andrew-abdelmalak/connect-4-robot/docs/Vision-Based-Connect-4-Robot-Supplement.pdf

# Vision-Based Connect-4 Robot: Supplementary Material

Andrew Abdelmalak, Daniel Boules, David Girgis, Kirolous Kirolous, Samir Yacoub, and Youssef Salama
Dept. of Mechatronics Engineering, German University in Cairo Cairo, Egypt

Abstract—This document accompanies our paper, Vision-Based Connect-4 Robot: Closed-Loop Game-State Extraction and Verified Token Placement. It collects the material the paper leaves out: how the design developed from a literature review to the final build, the parts and costs of the earlier and final designs, the dispenser’s actuation sequence, per-operation timing on the Raspberry Pi, and detailed drop, timing, and scenario results. All numbers come from the reports we wrote during the project. Where the final code uses different values, the text gives the code’s values.

I. HOW THE DESIGN DEVELOPED
A. Literature Review
We began by surveying three research threads that a visionguided Connect-4 robot depends on: board detection and game-state extraction [1], [2], token colour segmentation under changing light [3], [4], and manipulators for board games [5]. The paper’s related-work section discusses these works. The review fixed one design constraint early. Connect-4 tokens fall under gravity once released above a column, so the robot needs no grasping motion, only repeatable placement along one horizontal axis with an error below half the column pitch, about 20 mm on a standard board.
B. Image Pipeline and First Hardware
Next, we built and tested each image operation on a sample board photo: rotation and perspective warp, each with nearestneighbour and bilinear interpolation; a brightness shift and contrast scaling, each checked with histograms; and Gaussian smoothing at 3×3, 5×5, and 7×7 against a box filter. Bilinear interpolation removed the jagged cell boundaries that nearestneighbour sampling produced. The repository’s image-pipeline notebook reproduces these comparisons.
Two image features were defined to drive the actuator: the mean board brightness and the board’s rotation angle. On our test image the mean brightness was 91.19, which mapped to a motor speed of about 35% PWM duty. An Arduino prototype turned a servo from these two values; it is in the repository as
arduino/servo_prototype.
The first mechanism, modelled in SolidWorks, held a stack of tokens over a slide. A DC motor with an end effector pushed out the bottom token, and a servo-driven gate covered the columns that the token should pass, so that it slid into the target column. The planned electronics drove NEMA 17 stepper motors through L298N drivers. Table I lists the cost of this design.

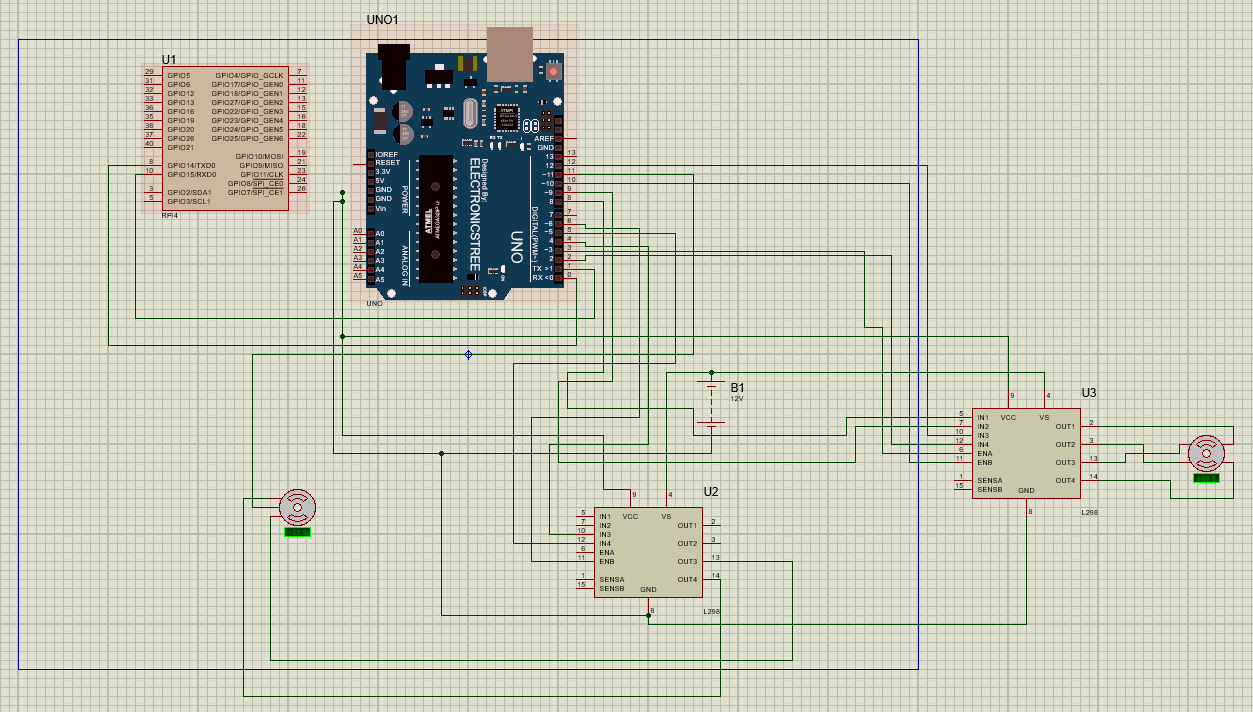
[picture p2: figure]

Fig. 1. Circuit simulated in Proteus for the closed-loop stage: the Arduino Uno, two L298N H-bridge modules for the motors, a 12 V supply, and the servo for the column gate.

C. Closed-Loop Integration

We then connected the stages into one loop: the Raspberry Pi reads the board, plans a move, and sends the column to the Arduino over USB serial, and a Flask dashboard shows the live camera streams. This version still used the stepper motors and the servo gate. Fig. 1 shows the circuit we simulated in Proteus for it.

D. Final Build

Closed-loop testing showed that a simpler split was more repeatable: a time-based carriage driven by a TT geared DC motor, and an encoder-coupled DC motor that releases exactly one token per turn of its disk. The carriage is a rod inside an open rail along the top of the board. At rest it waits out of the board, past the storage end, so every hole is open for the player. Column 1 sits under the chute and needs no move; for column N the rod slides out over columns 1 to N − 1, so the released token rolls along it by gravity and drops through column N, the first open hole. The rod then returns out of the board. The servo and the steppers were removed. The final build cost 6,100 EGP (Table I).

II. ACTUATION SEQUENCE

The Pi sends one ASCII digit, ‘1’ to ‘7’, at 9600 baud. Fig. 2 shows how the sketch that ran in the demonstrations handles each move. The repository’s

TABLE I
PARTS AND COST OF THE EARLIER AND FINAL DESIGNS (EGP)
Component | Qty | Total

Earlier design: steppers and a servo gate
Raspberry Pi 4 (4 GB) | 1 | 5,950
Arduino Uno | 1 | 450
Pi Camera V2 | 1 | 2,150
NEMA 17 stepper motor | 2 | 880
L298N driver | 2 | 170
SG90 micro servo | 1 | 85
12 V 5 A power supply | 1 | 300
Wires and breadboard | 1 | 150
Total | | 10,135

Final build: carriage and magazine
Raspberry Pi 4 (4 GB) | 1 | 4,250
Arduino Uno | 1 | 450
Pi Camera 5MP Rev 1.3 | 1 | 275
TT geared DC motor (carriage) | 1 | 50
Encoder DC motor (magazine) | 1 | 420
L298N H-bridge driver | 1 | 75
12 V 1.2 A power supply | 1 | 50
Wires, breadboard, structural parts | – | 530
Total | | 6,100

on serial input c in ’1’..’7’ and not busy: column <- c - ’0’; busy <- true
emit "BUSY column"
// 1. move the carriage to the column drive carriage out for duration[column] ms hard-brake carriage; wait 2000 ms
// 2. release exactly one token
pulses <- 0; drive magazine motor at fastSpeed while pulses < 430:
if pulses >= 430 - 40: magazine at slowSpeed hard-brake magazine; emit "MAG_PULSES pulses" wait 500 ms
// 3. return the carriage home
drive carriage back for the same time; hard-brake busy <- false; emit "DONE column"

Fig. 2. The dispenser’s per-move sequence, as pseudocode of the sketch that ran in the demonstrations.

arduino/dispenser/dispenser.ino is rebuilt from
this sequence, because the original file was not kept.
The magazine motor turns its disk about 1.075 times per release (430 encoder pulses at 400 counts per turn), which pushes the bottom token out of the storage tube. Hard braking drives both H-bridge inputs high for 100 ms before disabling the channel; it removed coasting and was a key source of repeatable positioning. Table II lists the calibrated carriage times.

III. TIMING ON THE RASPBERRY PI

Each pipeline operation was timed over 100 iterations on the Pi and on a laptop for reference (Table III). Both produce bitfor-bit identical images; the Pi is limited in throughput only. The brightness and contrast settings in the table are the ones used for this benchmark; the robot’s code applies a brightness shift of +20 and a contrast gain of 1.3. Minimax at depth 5

TABLE II
CALIBRATED CARRIAGE DRIVE TIME PER COLUMN
Column | Drive (ms) | Round trip (ms)
1 | 0 | 0
2 | 330 | 660
3 | 600 | 1,200
4 | 900 | 1,800
5 | 1,200 | 2,400
6 | 1,500 | 3,000
7 | 1,800 | 3,600

TABLE III
PER-OPERATION EXECUTION TIME, MEAN OF 100 ITERATIONS (MS)
Operation | Pi 4 | Laptop
Rotation (bilinear) | 8.468 | 3.273
Perspective warp | 3.596 | 1.768
Brightness +60 | 0.734 | 0.888
Contrast α = 1.8 | 1.111 | 0.201
Gaussian blur 5 × 5 | 0.757 | 0.097

typically took 0.2 to 1.4 s on the Pi in the early game, where the branching factor is highest, and less than 0.5 s in later positions.

IV. DETAILED RESULTS

A. Token Drops by Column
Each column received 20 drop trials; a drop succeeded when the token landed in the commanded column (Table IV). The misses on the outer columns come from drift in the time-based carriage positioning.
B. End-to-End Time
End-to-end time runs from the moment the column command is issued to the moment the camera verifies the new token in the commanded column. It ranged from 3.0 s at best to 15.0 s at worst, with an average of 7.5 s. The average case breaks down roughly as: 0.05 s vision, 0.01 s validation, 0.95 s minimax, 0.9 s carriage stroke out (middle columns), 2.0 s carriage pause, 0.7 s magazine release, 0.5 s settle, 0.9 s carriage stroke back, and 1.5 s verification. Moves to the home column skip both carriage strokes and finish in about 3 s; the slowest moves combine a far-column stroke with a verification retry after a borderline detection.
C. Closed-Loop Scenarios
- Mid-game states. Each of the 12 predefined simulator states was set up on the board, captured by the camera, and compared with the expected board. The validator accepted every legal change and rejected every injected illegal one, such as a chip floating two rows above the lowest empty row.
- Glare. A handheld light was swept across the board mid-game. The corner smoothing kept the warp stable; one or two frames gave spurious cell readings, and the validator rejected them without touching the trusted board. Clean

TABLE IV
DROP SUCCESS BY COLUMN
Column | Trials | Success
1 | 20 | 100%
2 | 20 | 100%
3 | 20 | 100%
4 | 20 | 95%
5 | 20 | 95%
6 | 20 | 90%
7 | 20 | 85%
All | 140 | 95%

readings returned within 1 to 2 frames after the light moved away.
- Outer-column stress. Twenty column-7 commands were sent in a row from a fresh board. Seventeen tokens landed in column 7 and three slipped into column 6; the camera check caught all three, and the robot stopped in its error state until reset.
D. Demonstration Video
Our final demonstration was recorded on video: three moves by a person and three by the robot, with the dashboard on a laptop beside the board. The project page shows a 20-second excerpt.

ACKNOWLEDGMENT
We thank Assoc. Prof. Dr. Eng. Omar M. Shehata, Eng. Dalia M. Mahfouz, PhD, Eng. Abdelrahman Hatem, MSc., and Eng. Mohammed Ashraf for their guidance.

REFERENCES

[1] G. Wolflein and O. Arandjelovi ¨ | c, “Determining chess game state from ´
an image,” J. Imaging, vol. 7, no. 6, p. 94, Jun. 2021.
[2] A. Masouris and J. van Gemert, “End-to-end chess recognition,” arXiv preprint arXiv:2310.04086, 2023, arXiv:2310.04086 [cs.CV].
[3] U. Akıs¸ and S. Dis¸litas¸, “Intelligent lighting system using color-based image processing for object detection in robotic handling applications,” Appl. Sci., vol. 14, no. 7, p. 3002, Apr. 2024.
[4] A. Ayub and A. R. Wagner, “Teach me what you want to play: Learning variants of connect four through human–robot interaction,” in Social Robotics (ICSR 2020), ser. Lecture Notes in Computer Science. Springer, 2020, pp. 502–515.
[5] C. Matuszek, B. Mayton, R. Aimi, M. P. Deisenroth, L. Bo, R. Chu,
M. Kung, L. LeGrand, J. R. Smith, and D. Fox, “Gambit: An autonomous chess-playing robotic system,” in Proc. IEEE Int. Conf. Robotics and Automation (ICRA), May 2011, pp. 4291–4297.
