andrew-abdelmalak/connect-4-robot/paper/figures/vision_pipeline.png

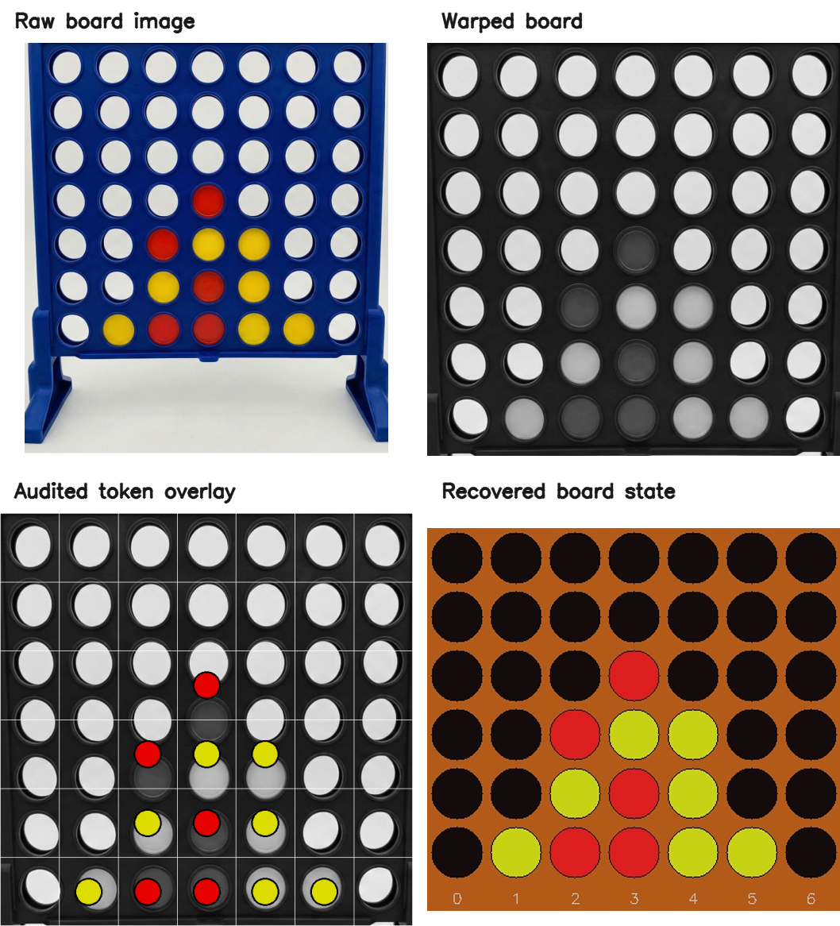
paper/figures/vision_pipeline.png
