andrew-abdelmalak/connect-4-robot/site/img/closed-loop-frames.webp

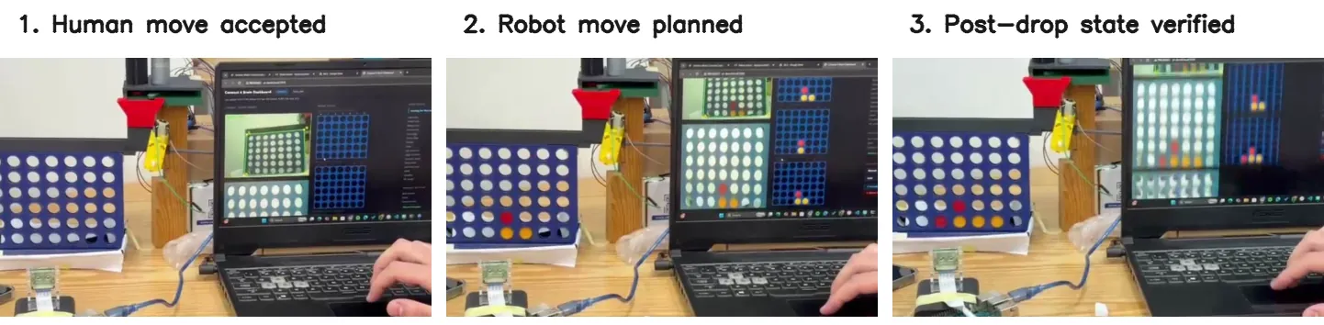
site/img/closed-loop-frames.webp
