andrew-abdelmalak/connect-4-robot/site/img/share.jpg

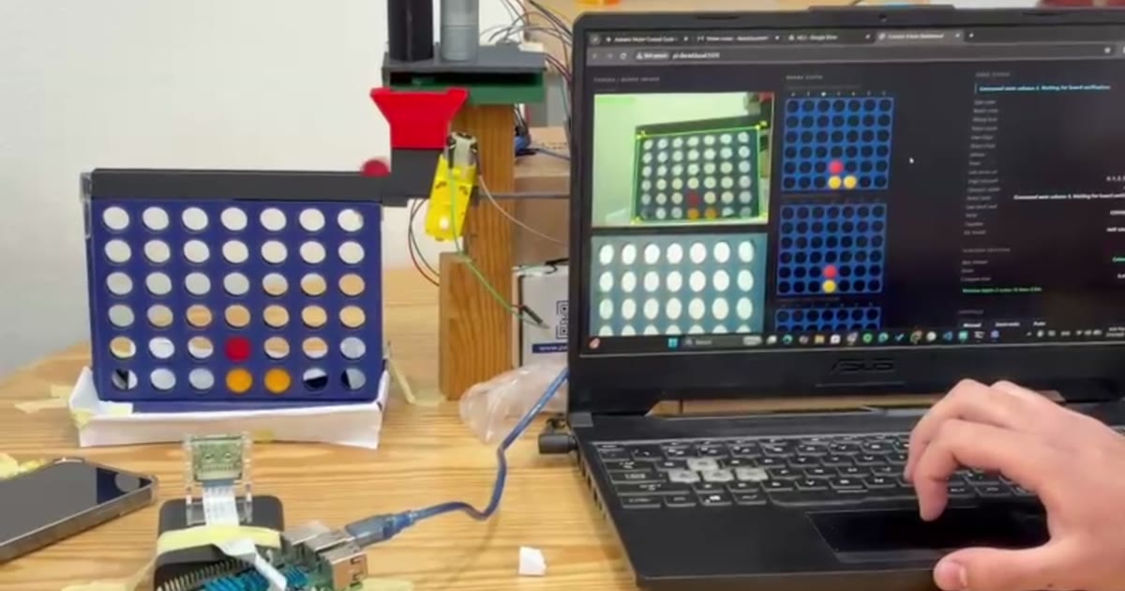
site/img/share.jpg
