andrew-abdelmalak/connect-4-robot/results/Image.png

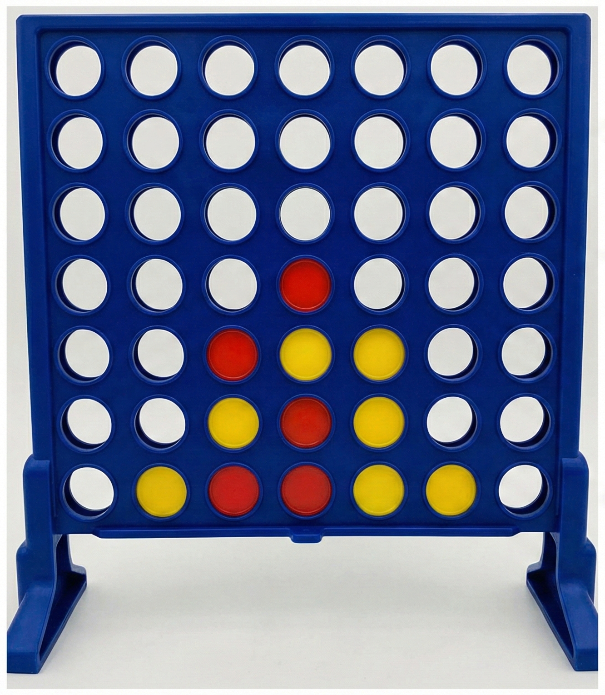
results/Image.png
