andrew-abdelmalak/connect-4-robot/results/m2_brightness_adjustment.png

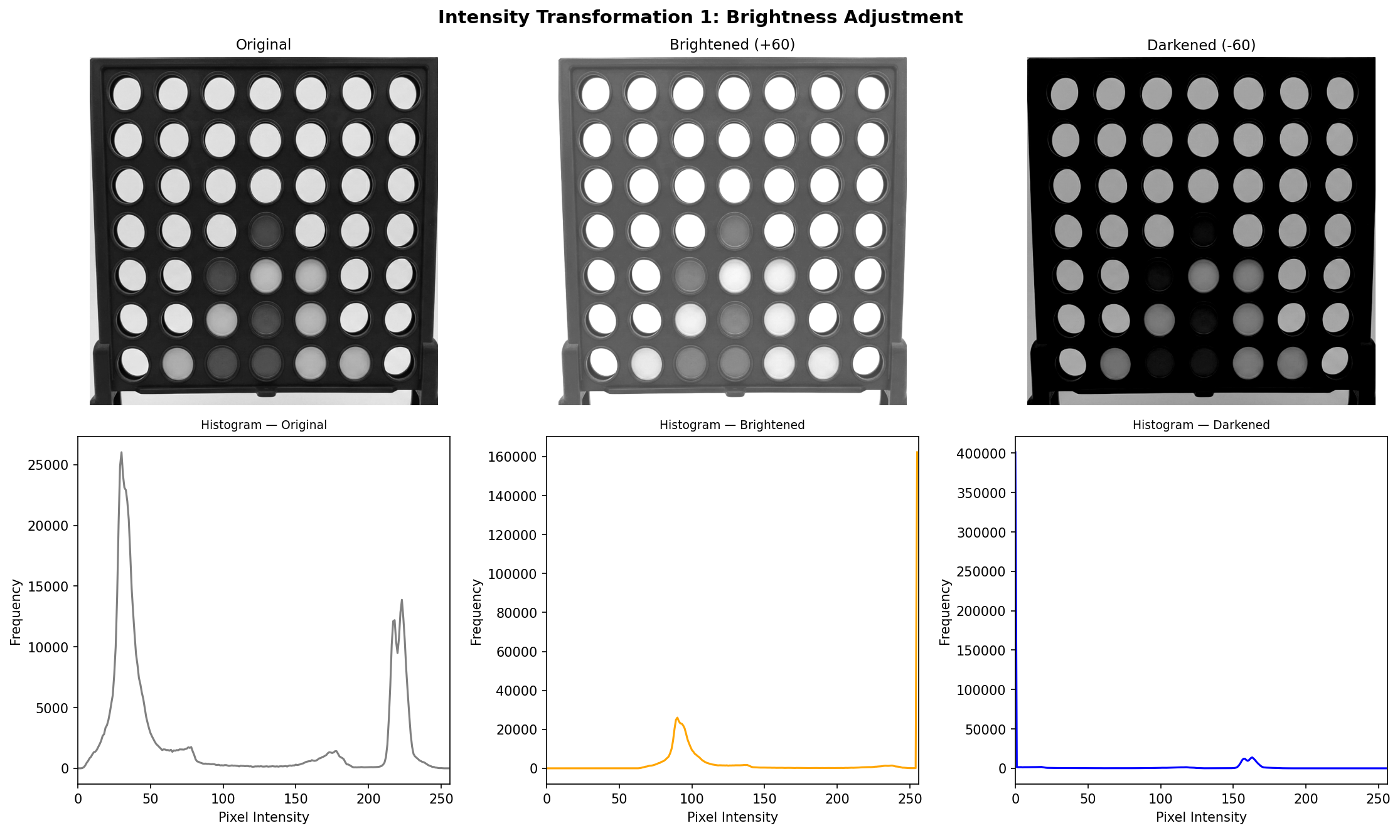
results/m2_brightness_adjustment.png
