andrew-abdelmalak/connect-4-robot/results/m2_input_board.png

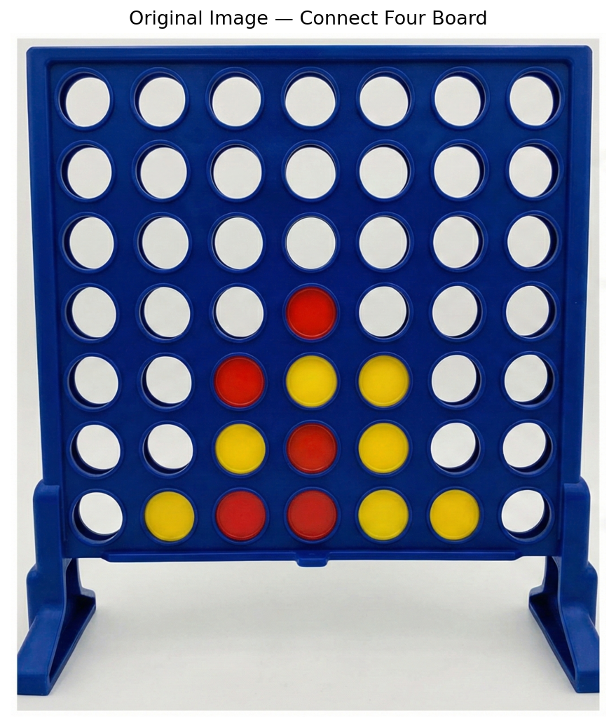
results/m2_input_board.png
