andrew-abdelmalak/connect-4-robot/results/m2_perspective_warp.png

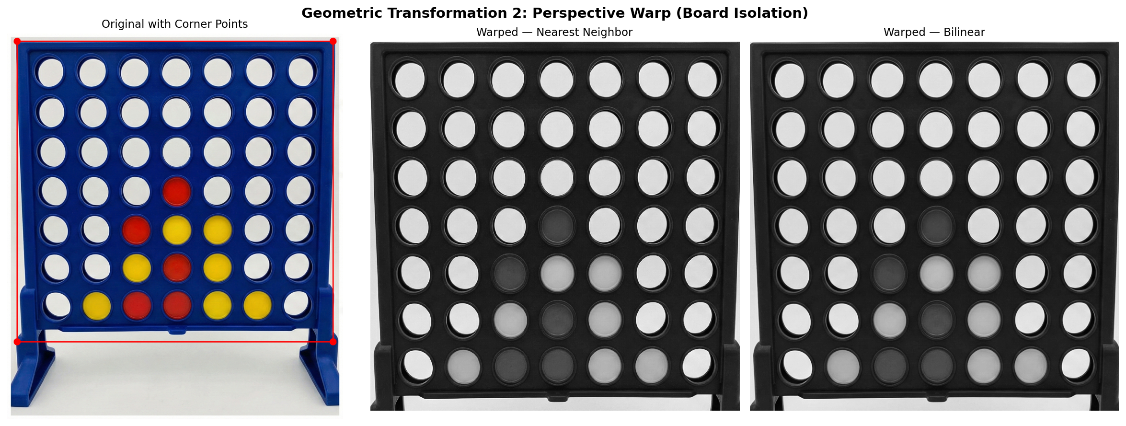
results/m2_perspective_warp.png
