andrew-abdelmalak/connect-4-robot/results/m2_rotation_comparison.png

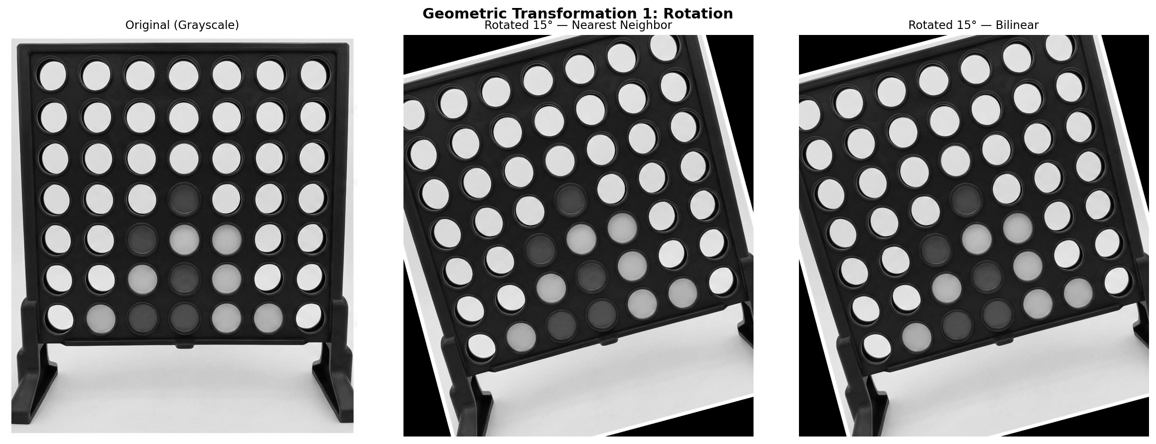
results/m2_rotation_comparison.png
