andrew-abdelmalak/connect-4-robot/results/m2_smoothing_comparison.png

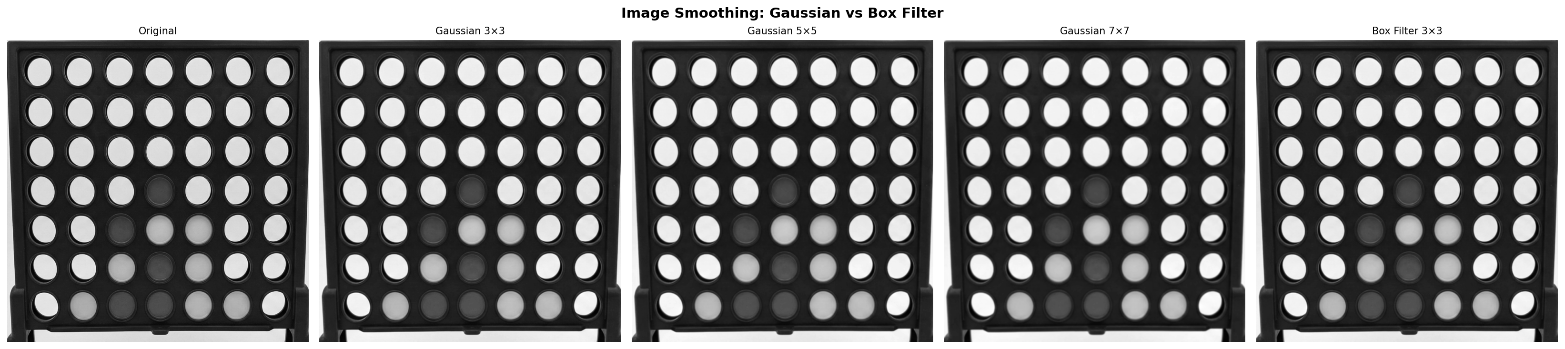
results/m2_smoothing_comparison.png
