andrew-abdelmalak/connect-4-robot/(commit log)

2026-05-04 fix: tighten paper table layout
2026-05-04 Integrate Pi runtime, actuator flow, and ML bonus path
2026-06-29 feat: final MS4/5 submission with playbook compliance — paper/main.tex
2026-06-29 feat: final MS4/5 submission with playbook compliance — paper/references.bib
2026-06-29 feat: final MS4/5 submission with playbook compliance — README.md
2026-06-29 feat: final MS4/5 submission with playbook compliance — CHANGELOG.md
2026-06-29 feat: final MS4/5 submission with playbook compliance — CONTRIBUTING.md
2026-06-29 feat: final MS4/5 submission with playbook compliance — LICENSE
2026-06-29 feat: final MS4/5 submission with playbook compliance — .gitignore
2026-06-29 feat: final MS4/5 submission with playbook compliance — requirements.txt
2026-06-29 feat: update source — src/runtime/connect4_brain.py
2026-06-29 feat: update source — src/runtime/train_cell_model.py
2026-06-29 feat: update source — src/image_pipeline/m1_image_acquisition.py
2026-06-29 feat: update source — src/image_pipeline/m2_member1_pipeline_notebook.ipynb
2026-06-29 feat: update source — src/image_pipeline/Image.png
2026-06-29 feat: update source — arduino/m1_servo_gate_controller/m1_servo_gate_controller.ino
2026-06-29 feat: update source — arduino/ms3_connectfour_dispenser/ConnectFour_Dispenser.ino
2026-06-29 feat: update source — paper/IEEEtran.cls
2026-06-29 feat: add figure — paper/figures/m1_proteus_circuit.png
2026-06-29 feat: add figure — results/m1_proteus_circuit.png
2026-06-29 feat: add figure — paper/figures/m2_brightness_adjustment.png
2026-06-29 feat: add figure — results/m2_brightness_adjustment.png
2026-06-29 feat: add figure — paper/figures/m2_contrast_scaling.png
2026-06-29 feat: add figure — results/m2_contrast_scaling.png
2026-06-29 feat: add figure — paper/figures/m2_input_board.png
2026-06-29 feat: add figure — results/m2_input_board.png
2026-06-29 feat: add figure — paper/figures/m2_perspective_warp.png
2026-06-29 feat: add figure — results/m2_perspective_warp.png
2026-06-29 feat: add figure — paper/figures/m2_rotation_comparison.png
2026-06-29 feat: add figure — results/m2_rotation_comparison.png
2026-06-29 feat: add figure — paper/figures/m2_smoothing_comparison.png
2026-06-29 feat: add figure — results/m2_smoothing_comparison.png
2026-06-29 feat: add figure — paper/figures/Image.png
2026-06-29 feat: add figure — results/Image.png
2026-06-29 docs: add milestone document — docs/MS1_Literature_Review.pdf
2026-06-29 docs: add milestone document — docs/MS2_Pipeline_Hardware.pdf
2026-06-29 docs: add milestone document — docs/MS3_Closed_Loop_Integration.pdf
2026-06-29 docs: add milestone document — docs/MS4_5_Final_Report.pdf
2026-06-29 docs: add milestone document — docs/Final_Presentation.pptx
2026-10-21 refactor: split the runtime into the connect4_robot package
    - board, minimax, game_state, simulator: pure Python (no OpenCV, Flask, or
    serial), so the same code can run in the browser
    - vision, hardware, dashboard: OpenCV, pyserial, Flask; dashboard HTML in
    its own file; entry point python -m connect4_robot / connect4-robot
    - named constants for tuned values (same values), type hints, docstrings
    - removed dead code: unused ROTATION_ANGLE, duplicate sim state, optional
    import guards for declared dependencies; fallback IP is now localhost
    - notebooks/, docs/figures/milestones/, arduino/dispenser/dispenser.ino
    (arduino-cli needs the folder and sketch names to match)
    - pyproject.toml rep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
2026-10-21 ci: lint, test, run the MS2 notebook, compile the Arduino sketches, and build the paper
    Actions pinned to commit SHAs, read-only token, Python 3.11 to match
    Raspberry Pi OS Bookworm; paper built with pdfLaTeX on TeX Live 2025
    (container pinned by digest) and uploaded as an artifact.
2026-10-21 fix: keep the camera and robot threads alive, harden routes, and simplify
    From the Python, security, and simplify reviews (tests first):
    - one bad frame or loop error no longer kills the camera or robot thread
    silently; the failure shows on the dashboard
    - malformed JSON on /set_mode and /set_classifier returns 400, not 500
    - --depth below 1 is refused (depth 0 sent column 0 over serial)
    - a reset during verification is no longer overwritten by an error
    - auto-accept reads candidate and detection state in one locked snapshot
    - the simulator starts a fresh game when it wraps past the last step
    - the dashboard no longer hides its controls after each button reply
    - one helper each for JPEG en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
2026-10-21 fix(paper): correct four references and match the deployed runtime values
    - Zubek2021 -> Ayub2020 (real authors Ali Ayub and Alan R. Wagner, ICSR 2020)
    - Rezaei2023 -> Masouris2023 (real authors Athanasios Masouris and Jan van Gemert)
    - Park2024 -> Akis2024 (real authors Uğur Akış and Serkan Dişlitaş)
    - Abarkan2024 cited a DOI that belongs to an unrelated paper; replaced with
    Gambit (Matuszek et al., ICRA 2011) and reworded the two sentences
    - brightness +20, contrast 1.3, carriage 0/330/600/900/1000/3000/4000 ms,
    400 pulses, release before carriage move, 2 s pause, 2.5 s settle, as in
    the committed runtime and sketch; notes the course report's +30 and 1.4
    docs/Vision-Based-Conne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
2026-10-21 docs: rewrite the README around the closed loop, with diagrams and a dashboard screenshot
    - what the two state gates do, results with their source, honest limitations
    (including the dispenser review findings and the board-detection case)
    - verified quick start (uv sync, connect4-robot --sim, pytest)
    - closed-loop and robot-state diagrams in light and dark
    - real dashboard screenshot from simulation mode
    - team with GitHub links; cost in EGP with USD context
2026-10-21 feat(site): prototype project page with a playable board running the real Python
    Pyodide 314.0.7 in a module Web Worker loads board.py, minimax.py, and
    game_state.py unchanged; the page draws the board, animates the dispenser,
    lets visitors try illegal boards against the real validator, and simulates
    missed drops at the per-column rates measured on the robot.
2026-10-21 feat(site): run the real vision pipeline on the board photo in the browser
    OpenCV and NumPy load on demand in Pyodide (about 14 MB); vision.py runs
    unchanged. Automatic detection reads 32 of 42 holes on the photo (the
    board's legs stretch the grid), the grid's own corners read 42 of 42.
    Board construction in the game now goes through Python apply_move too.
2026-10-21 feat(site): add two AI experiments, Ask the reports and a CLIP cell reader
    - Ask the reports: semantic search over the paper and the four milestone
    reports (171 passages, all-MiniLM-L6-v2 in the browser via transformers.js
    4.3.1), retrieval only; hit@3 0.88 on 16 test questions (test floor 0.8)
    - CLIP ViT-B/32 zero-shot on the photo's 42 holes: 36 of 42, against 42 of
    42 for the robot's HSV thresholds; computed offline by
    scripts/eval_clip_cells.py, labelled as a later one-photo experiment
2026-10-21 feat(site): Pages workflow, site wiring test, and design-detector fixes
    pages.yml assembles _site from site/, the unchanged src/connect4_robot
    modules, the board photo, and the PDFs (actions SHA-pinned). test_site.py
    fails if the worker or the workflow stops shipping the real modules.
2026-10-21 fix(site): apply finish, JS, and Python review findings
    - flows guarded against New game mid-turn, errors unlock the board, fix
    button cannot double-submit, focus returns to a column, digit keys only in
    the column bar without modifiers, worker errors reject pending calls
    - validator messages shown with columns 1-7 and rows from the bottom;
    rejection reasons announced; gate text set as text, not HTML
    - royal-blue field, dispenser redrawn as a funnel carriage with a visible
    animation label, a blue band below the hero, honest result bars, no
    decorative bullets; fonts self-hosted (OFL), raster provenance recorded
    - search: sentence-aligned passages, small-caps rejoined, one-at-a-time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
2026-10-21 fix(site): seven-column grid below the hero, plastic rail, cleaner search passages
    - reading sections lay out on the board's seven columns, with a hole-row
    rule above each heading
    - blue plastic dispenser rail; space reserved so the funnel never covers text
    - search passages: sentences kept whole across page breaks, table runs
    dropped; hit@3 13 of 16 (page copy updated)
2026-10-21 fix(site): fit the board inside the phone gutters (it overflowed its column by 4 px)
2026-10-21 fix(site): round-3 review items
    - search passages split at section headings and table captions, table runs
    dropped, compound hyphens restored where the documents spell them; hit@3
    back to 14 of 16
    - even chart labels, hole-row rule above The robot, and a note that the MS3
    report priced an earlier design at 10,135 EGP
2026-10-21 feat(site): run the whole robot loop on the real code
    - Arduino: the compiled dispenser sketch runs on an emulated Uno
    (avr8js 0.21.1); the page shows its serial lines, pin traces, encoder
    count, and carriage, and the Pages build compiles the .hex
    - camera: each turn draws a board picture that the real VisionPipeline
    reads; gate 2 follows RobotController's timing from hardware.py
    - minimax: per-column scores, positions searched, and a depth setting;
    a test checks the scores explain the robot's choice
    - options: colour, depth 1 to 5, Arduino speed, step by step; tokens fall
    from the funnel; a win is marked and celebrated
    - results as plain per-column bars, CLIP in plain words, the v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
2026-10-21 fix(site): review fixes for the robot loop
    - steps read 1 to 6: gate 2 has its own Camera check pane
    - visible labels for the score row and the missed-drop rates
    - phone: board right after the headline; laptop: the sticky board column fits a 768 px screen
    - step mode no longer freezes after DONE; gate 2 waits for the frame being read
    - an emulator failure or error mid-move unlocks the board and idles the Arduino
    - a rejected operator fix restores the fix button; settings sync at startup; depth locked mid-move
2026-10-21 fix(site): show the operator fix in the camera check step
2026-10-22 feat(site): sliding token switches for step mode and misses
    A recessed slot with an empty hole that slides into a yellow token when on,
    with role=switch, a focus ring, and no motion under reduced motion.
2026-10-22 fix(site): squash the switch knob with transform, not width
2026-10-22 feat(site): show the magazine and motors on the board; polish the dropdowns
    - a magazine tube over home with the robot's tokens and a release wheel that
    turns while the sketch drives the magazine motor; a token drops into the
    carriage when the sketch prints MAG
    - magazine and carriage motor gears under the rail, spinning while the
    emulated pins drive them, with their real PWM duty and pulse count
    - dropdowns: a rounded chevron, hover and focus states, dark option lists
    - say we in the README and the team section
2026-10-22 feat(site): Watch it play, 20 seconds of our real demo
    - a muted clip from our final demo video (MS4/5 report section IX): the
    dashboard shows minimax choosing in 0.495 s, the carriage drops a red token,
    and the camera picture updates; plays only while on screen and never under
    reduced motion, with a Play/Pause button whose pause sticks
    - a link to the whole 2.5-minute demo on Google Drive
    - the README opens with a 12-second animated preview linked to the section
    - provenance notes for each clip, poster, and preview
2026-10-24 feat(search): read the paper's passages from its LaTeX source
    - scripts/paper_latex.py turns paper/main.tex into passages that stay inside
    their section and carry its label as the PDF prints it (IV., VI-B.);
    citations, figure, table, and equation numbers resolve to the printed
    ones; figures, equations, and the author block are left out; the table
    becomes one passage; an unknown LaTeX command stops the build
    - the index builder places each passage on its PDF page and checks it there:
    90% of its three-word runs and every number, or every table cell
    - results show the section; the table's link highlights its header row
    - tests: the committed index matches the parser (runs in CI withou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
2026-10-24 feat(site): icon, phone menu, engineers section, paper card, saved search
    - site icon (a red and a yellow token on board blue), theme colour, and
    link-preview tags with a frame from our demo video
    - phones get a numbered menu of every section (it had only Code); a
    back-to-top button once past the game
    - For engineers: the closed-loop and controller-state diagrams with their
    descriptions as captions, the robot from the side (from our final
    presentation), and a map of the code; pictures open in an image viewer
    - a paper card: kind, authors in paper order, course, and Read, LaTeX
    source, Cite, and code links
    - Ask the reports keeps the last search for the tab, so Back from the PDF
    b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
2026-10-24 fix(site): draw the dispenser as our SolidWorks drafts show it
    The magazine, its motor disk, and the base are fixed at the right end; the
    carriage is the slider (the funnel) and its long channel. At home the
    channel's exit sits over column 1, so the token falls into the funnel,
    slides down the channel to the exit, and the carriage then drives the exit
    over the column. Matches the demo footage, the gravity-fed channel in the
    MS4/5 report, and the sketch's 0 ms for column 1.
2026-10-24 fix(site): feedback round 1
    - no Google Drive links: the clip's caption and the provenance notes cite the
    MS4/5 report's QR code instead
    - the diagrams section is How it works, as on our other project page; the
    two-checks band is Two checks in the menu
    - bar labels keep their whole text on phones (20 of 20 (100%) was cut)
    - less empty space between sections (about 120 px on desktop, was 192)
    - the magazine is a real stack: the robot's 21 tokens, five in view; each
    release takes the bottom one out and the rest fall one slot
2026-10-25 fix(dispenser): rebuild the sketch from the MS4/5 report's Listing 1
    The demo ran the order in the final report: the carriage moves to the
    column and holds 2 s, the magazine releases one token (430 pulses), and
    0.5 s later the carriage returns. The repo's sketch released first, which
    cannot work when the token rolls to the first open hole by gravity.
    - dispenser.ino: rebuilt from Listing 1 and Table II (0, 330, 600, 900,
    1200, 1500, 1800 ms); pins, motor speeds, READY and ERR kept from the
    earlier sketch; the encoder count is read with interrupts paused
    - site: the carriage is the moving rod at the storage end; the token
    drops after the release and rolls along the rail (8 holes a seco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
2026-10-25 feat(site): the hero dispenser is the cutaway from our mechanism draft
    The strip above the board is now drawn from the robot's side on the
    board's own grid: the storage tube, motor disk, and chute over column 1,
    and the rail along the board with the carriage, a rod, inside it. The
    compiled sketch moves it: the rod slides out and covers the holes before
    the target, the disk turns with the encoder count, the bottom token
    leaves the tube, and the released token rolls along the rod to the first
    open hole. The parts at work stay bright while the others step back.
    - the scores row moves above the dispenser, so the rail sits on the board
    - labels show on wide screens; on phones the drawing stands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
2026-10-25 chore: present one project, not course milestones
    - renamed: arduino/servo_prototype, notebooks/image_acquisition.py,
    notebooks/image_pipeline.ipynb (re-run under the new name), and
    docs/figures/pipeline/ plus docs/figures/proteus_circuit.png
    - removed the poster file (docs/Final_Presentation.pptx); it listed the
    team's student emails and IDs and described the earlier stepper and
    servo hardware
    - "Team 21" is now "a team of six"; provenance notes say "our"
    - README links open the paper in the site's PDF viewer
    - site: "How it works" links to #how-it-works; where the browser
    supports it, the open dropdown list matches the closed pill
    - CI, CONTRIBUTING, and the changelog drop the mi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
2026-10-25 docs: one paper and its supplement in place of the course reports
    - paper/supplement.tex (built by the paper workflow, PDF in docs/):
    how the design developed, the earlier and final parts and costs, the
    actuation sequence and carriage times, per-operation timing, drops by
    column, end-to-end time, closed-loop scenarios, and the instructors
    - removed the four course reports; everything the README and site cite
    from them is now in the supplement
    - search covers the paper and the supplement ("Ask the paper"); renamed
    build_search_index.py, search-index.json, test_search_index.py
    - paper figures lose the final_ prefix; the paper's text is unchanged
    - README team section names all four i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
2026-10-25 feat(site): drop the miss toggle and the CLIP experiment; the team section is the paper card
    - removed "Miss as often as the real robot" with its whole flow: the
    random misdrop, the operator fix button, and its notes. Gate 2 keeps
    the robot's real timeout path: no matching board in time stops the
    robot until New game. The results chart still shows the measured drops.
    - removed the CLIP experiment (section, script, results file, test);
    "Ask the paper" is now its own section, and its accuracy note says 13
    of 16, the current search test result
    - Who we are is the paper card alone, now naming the instructors and
    linking the supplement
2026-10-26 feat(site): reorder and reweight the page around the story, not the demo clips
    - order: hero, watch it play, two checks, the robot, results and limits,
    how it works, the paper and the team
    - watch it play: the clip at two thirds of the width beside its text
    - two checks: the closed-loop diagram in place of three frames from the
    same demo video
    - the robot: the side photo, the only view not taken from the demo video
    - results and limits: plain tables (reading accuracy, drops per column,
    time per move) at the same weight as the limits right under them; the
    big drop-bar chart is gone
    - how it works: the paper's vision-pipeline figure with the four reading
    steps, the states diagram on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
2026-10-27 fix(site): the dispenser as it worked: storage over column 7, rod opens toward it
    The demo video and the code agree: the Pi camera stands in front, the code's
    column 1 is the end far from the storage, and the carriage times grow toward
    the storage. At rest the rod covers every hole except column 1; for column N
    it slides toward the storage by N-1 holes, so the released token rolls from
    the storage end and drops through column N.
    - site: storage, disk, chute, and rod motor at the right end over column 7;
    the rod rests over columns 2 to 7 and opens toward the storage; the token
    rolls right to left; messages and comments follow
    - dispenser.ino header and the supplement describe the same mo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
2026-10-28 site: remove the cheat panel and the photo test; fix the column halo, trace labels, and fast-mode drop
    - remove the Try to cheat panel and the demo-photo read, with their code,
    styles, worker functions, and the Pages copy of the sample photo
    - refocus a column after the robot's move only when the visitor plays by keyboard
    - move the trace labels above the plot so the line labels are not cut
    - hold the emulated Arduino while the token rolls and drops, so the rod
    never closes over a token at full speed; its clock pauses with it
    - share.jpg: the new 1200x630 preview
2026-10-28 site: report the Python runtime's real download progress
    The worker fetches the runtime's two large files itself and posts the
    bytes received, then Pyodide reads them from the browser cache. The page
    raises each step as a brain-progress event. The trace canvas takes its
    height from CSS.
2026-10-29 site: rebuild the hero around the game and a six-step bar
    - the game takes the left column and fits in one screen from 1024 px up:
    the board follows the screen's height, and settings sit under it
    - the headline, a six-step bar, and one instrument window (Camera,
    Arduino, Boot log) on the right; the window follows the part at work,
    and each move ends on the camera check or on the step that failed
    - while Python downloads, the board's holes light with the bytes received
    and the boot log shows each step with its time; the Arduino powers on
    at the same time
    - a column picked while loading, by mouse, touch, or keyboard, waits for
    the robot and then drops
    - the motors row is gone: the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
2026-10-29 site: settings with short labels and notes; room around the step bar and traces
    - 'Looks ahead' and 'Arduino' sit beside their selects, with short options,
    and each setting has an i button that opens a note on what it does
    - the step bar and the signal traces get a margin on every side
    - a step that passes no longer moves the instrument window: the camera
    check often passes while the carriage drives home, so the window stays
    on the Arduino until the next move
    - each motor's name and state share a line; short screens get a tighter
    right column
2026-10-29 site: confirm New game mid-game; notes open on hover and read as option rows
    - New game during a game turns into 'Yes, start over' with Keep playing
    beside it, and goes back after six seconds
    - each setting's note opens on hover or focus and stays open on click or
    tap; it shows a title, one line, and a row per option
    - the depth setting reads 'Moves ahead' with plain numbers
    - a fresh board puts the step caption back on step 1
2026-10-29 site: the person's token goes straight into the board's top slot, not through the rail
2026-10-29 site: polish the board, notes, and step bar
    - New game and a colour change ask on the board itself (Start over or
    Keep playing; Esc keeps playing and the focus goes back)
    - each column's hit area is a hole plus a gap wide, so its highlight is
    centred on the outer columns too
    - the i is an SVG icon, centred in its circle; on a phone a note spans
    the screen with a margin each side
    - the step in focus gets a short bar under its whole name, with the room
    kept on every step so nothing shifts
    - the trace lane names size to their rows; the serial log has a thin
    scrollbar
2026-10-29 fix: the rod rests out of the board, so every hole is open for the player
    At rest the rod waits past the storage end, beside column 1. Column 1 sits
    under the chute and needs no move; for column N the rod slides out over
    columns 1 to N-1, the released token rolls along it and drops in column N,
    and the rod returns out of the board. Table II's times fit this order
    unchanged.
    - site: storage, disk, and chute drawn over column 1; the rod slides in
    from outside the board; the robot's token rolls from column 1 to its
    target; the person's token drops through the open rail; serial
    captions and the carriage state say what the rod covers
    - dispenser.ino header, supplement (rebuilt PDF), and se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
2026-10-29 site: draw the board from the player's side, storage and rod at the right
    Column 1, under the storage and chute, is at the right end, as in the demo
    video: the board, its columns, the scores, and the rail run right to left,
    and the rod rests out of the board past the right end. Arrow keys follow
    the board. The Camera tab keeps the camera's own picture, mirrored from
    the player's view, and says so.
2026-10-29 fix(site): audit batch A, correctness and accessibility
    - How it reads the board: the list had the hero step bar's class, so it
    inherited a 6-column grid and lost its numbers (overlapping words on
    phones). It now has its own class; a test keeps the step bar's class
    unique.
    - Screen readers: each column button says what the column holds, and the
    status line says where the winning four is.
    - The rail shows the column numbers 1 to 7 (1 under the chute), so the
    number keys and the robot's messages match what is on screen.
    - Gate 2 on slow devices: the emulated Uno waits while the page reads a
    camera frame, as it already did while a token falls, so a match is
    reported at the robot's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
2026-10-29 docs: the camera stood in front of the board; clearer claims
    - The camera was a Pi camera module on the table in front of the board,
    as the photos show, not overhead: paper (abstract, setup, perception),
    README alt text, and the closed-loop diagram label.
    - The course suite's 31 of 31 checks: the paper says that file was not
    kept and that the repository has its own automated tests.
    - Misses grow toward the far columns (column 7), not "the edges":
    column 1 is an edge column and needs no rod travel.
    - End-to-end time runs from an accepted board to a verified robot move,
    as in the paper, in the supplement, README, and site too.
    - Site: the Camera tab note states what the code reads (c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
